vyomvmehta/RoboArm/README.md

# RoboArm

A 5-servo desktop robot arm, designed in SolidWorks and 3D printed. Web-controlled in V1, gesture-controlled in V2.

- **V1 (in progress):** controlled from a web page on a laptop or phone. Drag a slider per joint, or type a point and the arm's inverse kinematics moves the gripper there.
- **V2 (next):** controlled by hand gestures. A webcam tracks your hand with MediaPipe; move your hand and the arm follows, pinch to close the gripper.

**Status (Nov 2026):** in progress. The plan, the laptop↔Arduino protocol and the arm's kinematics (with tests) are done. CAD, printing and electronics are next. Target: V1 controlled live from the web page in December 2026, then a pick-and-place demo and write-up in January 2027. V2 (gestures) follows.

**Team:** Vyom Mehta, Ishaan, Siddharth (University of Waterloo).

## How it works

```
V1: web page (laptop/phone) ─┐
                             ├→ Laptop (Python): target point → IK → Arduino Nano → PCA9685 → 5 servos
V2: webcam + hand tracking ──┘                                     (USB serial)    (I²C)
```

| Joint | Servo | Job |
| --- | --- | --- |
| J0 base | MG996R | Turns the arm left/right |
| J1 shoulder | MG996R | Raises/lowers the upper arm |
| J2 elbow | MG996R | Bends the forearm |
| J3 wrist | MG90S | Sets the gripper's angle |
| J4 gripper | MG90S | Opens/closes the two-jaw gripper |

## Repository

```
arm/kinematics/   forward + inverse kinematics
tests/            unit tests (run: python -m pytest)
docs/             PROTOCOL (laptop↔Arduino messages), TORQUE (arm-size strength check),
                  TIMELINE, DECISIONS, CHECKLIST
```

More folders (CAD, firmware, vision, config) arrive as each part is built.

## Run the tests

```
pip install pytest
python -m pytest -q
```

## How we built this

We use Claude Code (an AI assistant) as a tutor and pair programmer. It explains concepts before we build them and writes some of the code and docs. For example, the inverse kinematics was derived by hand first, then coded with Claude's help. A full account of who did what will be here with the final write-up.
