vyomvmehta/RoboArm/docs/img/base_rotation.gif

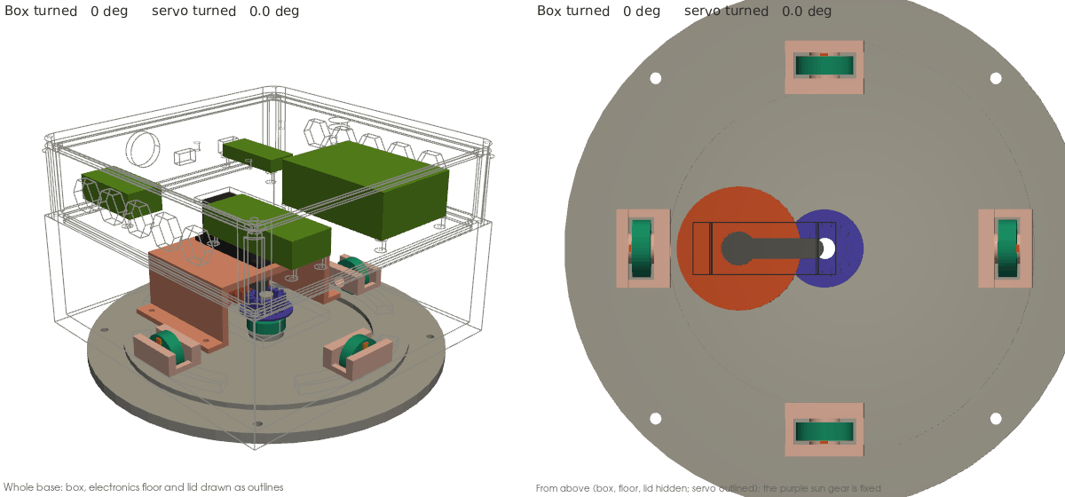
docs/img/base_rotation.gif
