vyomvmehta/RoboArm/SolidWorks Parts/README.md

# SolidWorks Parts

All CAD for the arm lives here and is shared through GitHub, like the code.

```
SolidWorks Parts/
  Test Prints/   test pieces for print clearances (batch A); throwaway, not part of the arm
  *.SLDPRT       arm parts: base, turntable, shoulder bracket, links, wrist, gripper
  *.SLDASM       the full arm assembly
  STL/           print files exported from the parts above (batch B and reprints)
```

## Rules

- **Keep the arm's parts and its assembly in this one folder.** A SolidWorks assembly finds its parts by file name, and looks in its own folder first. That way it opens on every laptop, wherever the repo is cloned.
- **Never rename a part to make a new version** (no `_v2`). Renaming breaks the assembly's links to it. Git already keeps every version: change the file, commit it, and say what changed in the commit message.
- **One person edits a file at a time.** SolidWorks files are binary, so git can't merge two people's changes; one person's work would be lost. Say in the group chat before editing a part someone else owns, and pull first.
- **Pull before you open, push when you're done:** `git pull` → edit → save → commit → push (through a pull request, like code).
- **Export STLs in millimetres, resolution Fine,** into `STL/`. Re-export after every change, so the STL never lags behind the part.
- Lock files (`~$*.SLDPRT`) and backups (`*.SLDBAK`) are ignored by git; don't force-add them.

## Test Prints

| File | What it tests |
| --- | --- |
| `Screw_Strip.SLDPRT` / `.STL` / `.3MF` | M3 screw holes 3.0 / 3.2 / 3.4 mm, M3 nut pockets 5.6 / 5.8 / 6.0 mm across the flats |
| `bearing_block.py` → `bearing_block.stl` | 608 bearing seats 22.0 / 22.2 / 22.4 mm. Generated by the script (`py "SolidWorks Parts/Test Prints/bearing_block.py"`, needs `pip install manifold3d`) |
| `motor_frames.py` → `mg996r_frames.stl`, `mg90s_frames.stl` | MG996R (19.8 × 40.5) and MG90S (11.9 × 22.8) body pockets at +0.10 / +0.25 / +0.40 mm (labels 10 / 25 / 40) |

The fits that work are recorded in `docs/DECISIONS.md` (D15).
