vyomvmehta/RoboArm/SolidWorks Parts/grap_base_assembly.step

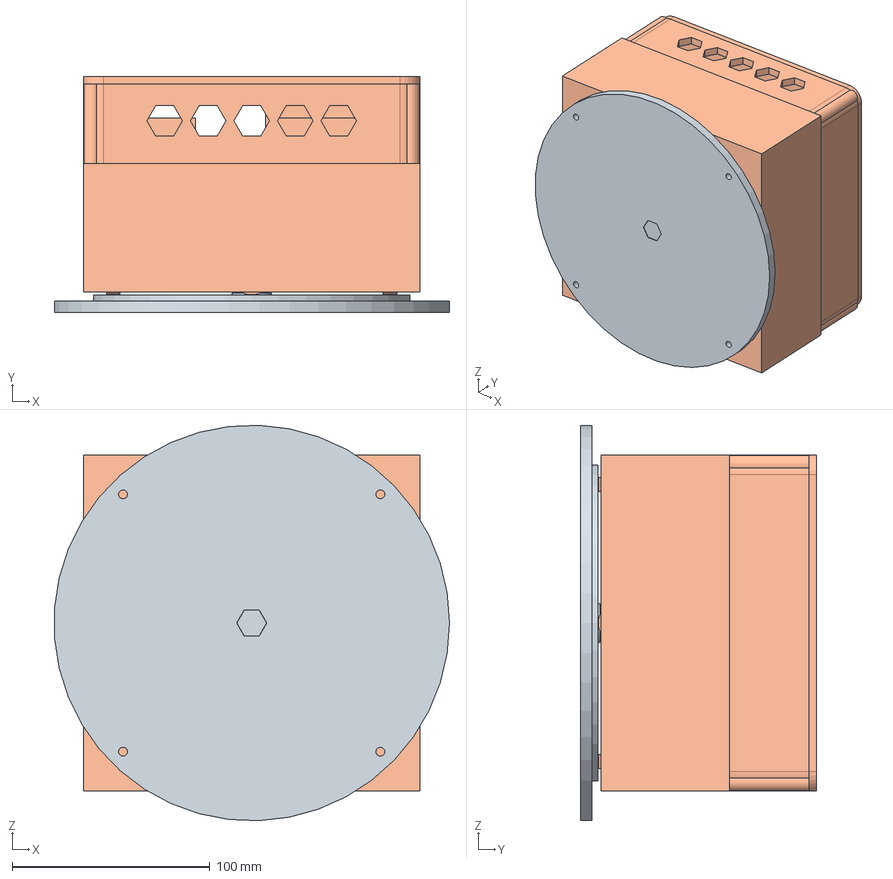
[picture p2: CAD file, 2026-11-14]
SolidWorks Parts/grap_base_assembly.step
199.7 x 119.5 x 199.9 mm
base
pivot_bolt
sun_gear
planet_gear
horn
servo
servo_bridge
pivot_bearing
fork0
wheel0
fork1
wheel1
fork2
wheel2
fork3
wheel3
tier
board_pca9685
board_perfboard
board_lm2596
board_nano
lid
