vyomvmehta/RoboArm/SolidWorks Parts/grap_planet_gear.step

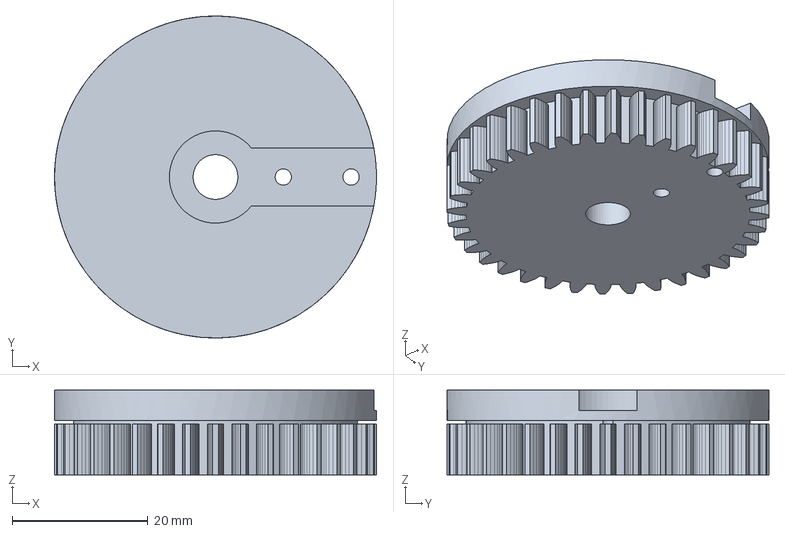
[picture p3: CAD file, 2026-11-14]
SolidWorks Parts/grap_planet_gear.step
47.5 x 47.5 x 12.5 mm
