vyomvmehta/RoboArm/SolidWorks Parts/Test Prints/mg996r_frames.stl

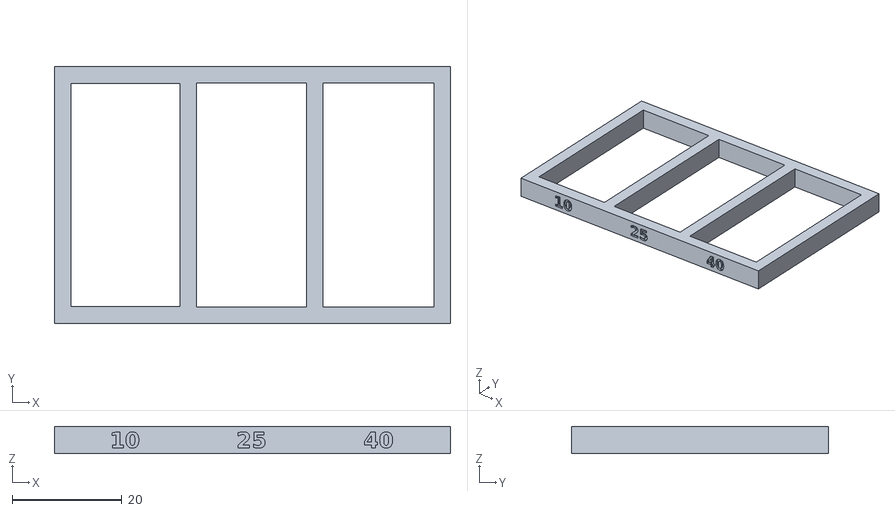
[picture p4: CAD file, 2026-11-04]
SolidWorks Parts/Test Prints/mg996r_frames.stl
72.2 x 46.9 x 5.00
