vyomvmehta/RoboArm/SolidWorks Parts/grap_lid.step

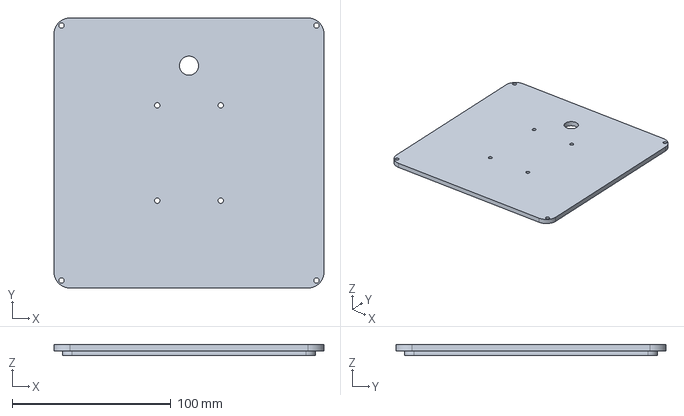
[picture p5: CAD file, 2026-11-14]
SolidWorks Parts/grap_lid.step
170.0 x 170.0 x 7.00 mm
