vyomvmehta/RoboArm/SolidWorks Parts/Test Prints/mg90s_frames.stl

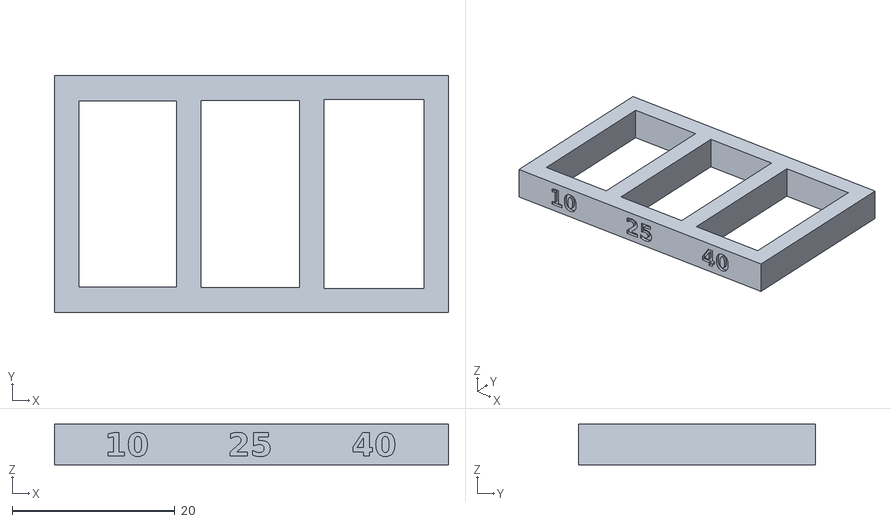
[picture p6: CAD file, 2026-11-04]
SolidWorks Parts/Test Prints/mg90s_frames.stl
48.5 x 29.2 x 5.00
