vyomvmehta/RoboArm/SolidWorks Parts/grap_wheel_fork.step

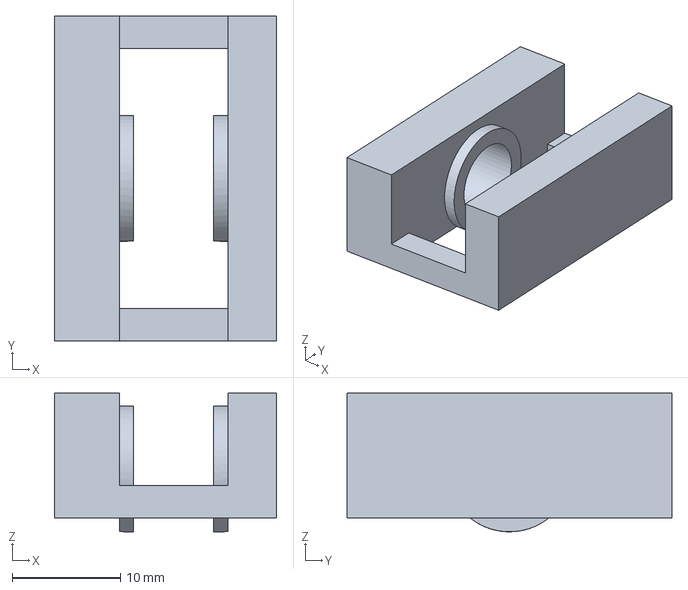
[picture p7: CAD file, 2026-11-14]
SolidWorks Parts/grap_wheel_fork.step
20.5 x 30.0 x 12.8 mm
