vyomvmehta/RoboArm/SolidWorks Parts/Test Prints/bearing_block.stl

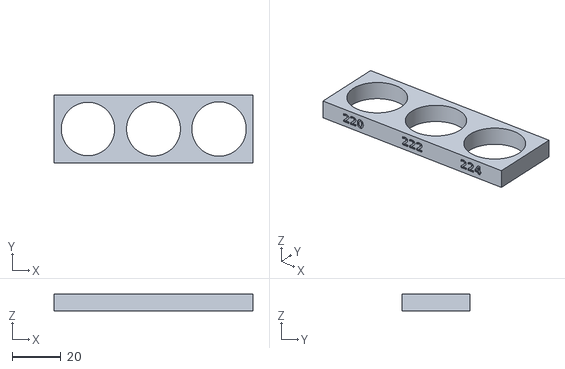
[picture p8: CAD file, 2026-11-04]
SolidWorks Parts/Test Prints/bearing_block.stl
82.0 x 28.0 x 7.00
