vyomvmehta/RoboArm/SolidWorks Parts/grap_servo_bridge.step

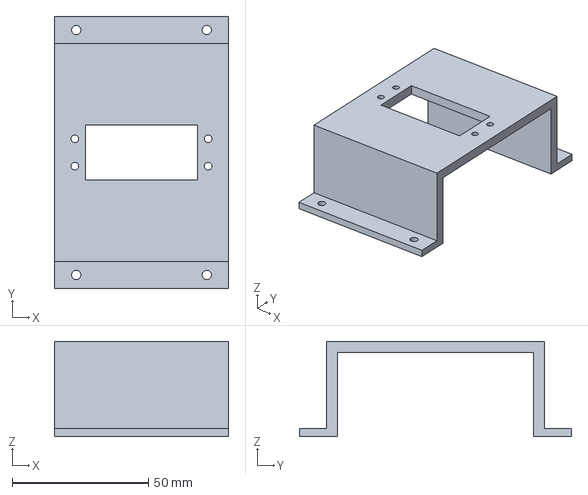
[picture p9: CAD file, 2026-11-14]
SolidWorks Parts/grap_servo_bridge.step
64.0 x 100.0 x 35.0 mm
