vyomvmehta/RoboArm/SolidWorks Parts/grap_sun_gear.step

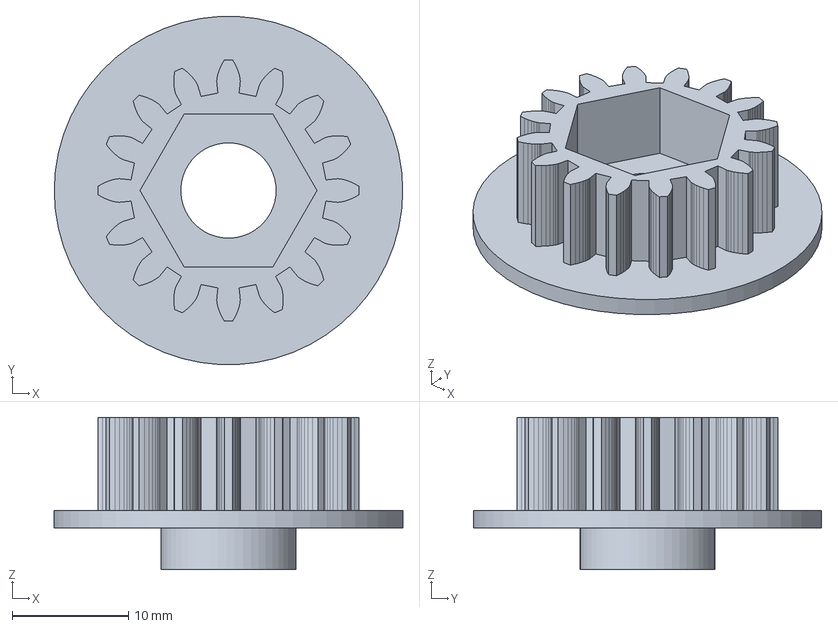
[picture p10: CAD file, 2026-11-14]
SolidWorks Parts/grap_sun_gear.step
30.0 x 30.0 x 13.1 mm
