vyomvmehta/RoboArm/SolidWorks Parts/grap_electronics_tier.step

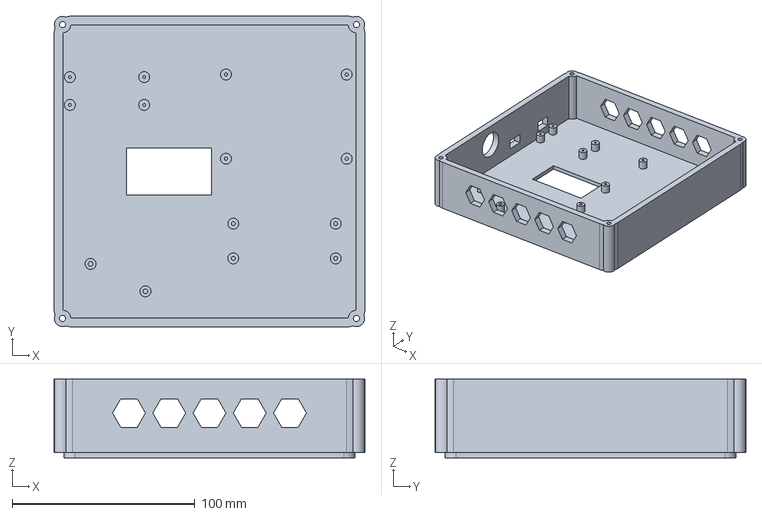
[picture p11: CAD file, 2026-11-14]
SolidWorks Parts/grap_electronics_tier.step
170.0 x 170.0 x 43.0 mm
