vyomvmehta/RoboArm/SolidWorks Parts/grap_base.step

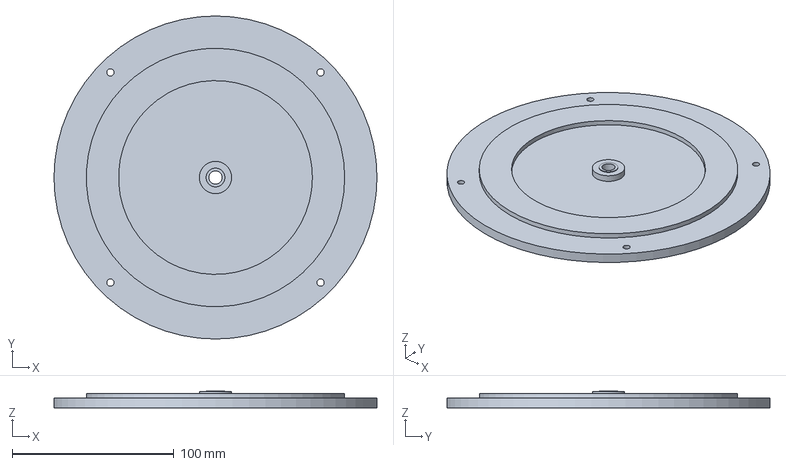
[picture p12: CAD file, 2026-11-14]
SolidWorks Parts/grap_base.step
200.0 x 200.0 x 10.4 mm
