vyomvmehta/RoboArm/SolidWorks Parts/Enclosure.SLDPRT

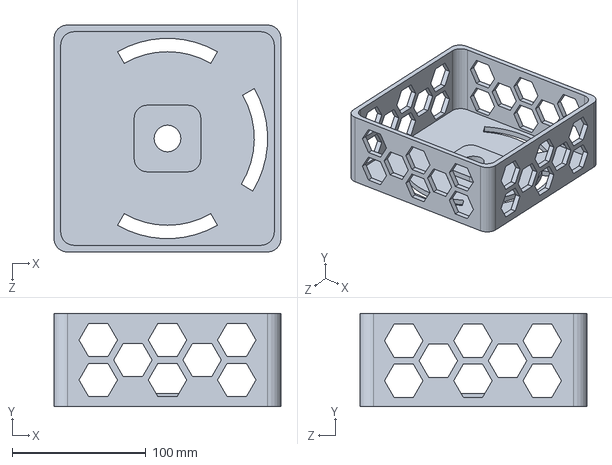
[picture p13: CAD file, 2026-11-14]
SolidWorks Parts/Enclosure.SLDPRT
170.0 x 70.0 x 170.0 mm
