vyomvmehta/RoboArm/SolidWorks Parts/Test Prints/Screw_Strip.SLDPRT

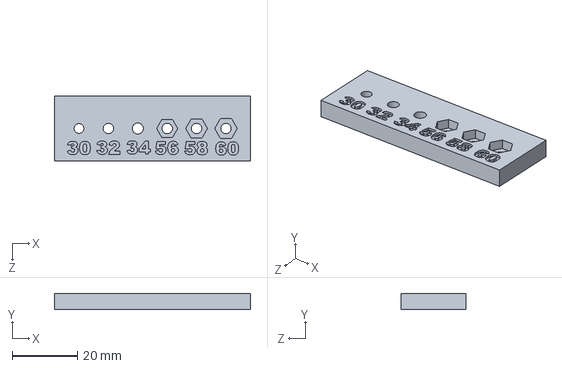
[picture p14: CAD file, 2026-11-04]
SolidWorks Parts/Test Prints/Screw_Strip.SLDPRT
60.0 x 5.00 x 20.0 mm
