vyomvmehta/RoboArm/(list of files, cad)

Other CAD files:
SolidWorks Parts/STL/grap_base.stl
SolidWorks Parts/STL/grap_electronics_tier.stl
SolidWorks Parts/STL/grap_lid.stl
SolidWorks Parts/STL/grap_planet_gear.stl
SolidWorks Parts/STL/grap_servo_bridge.stl
SolidWorks Parts/STL/grap_sun_gear.stl
SolidWorks Parts/STL/grap_wheel_fork.stl
SolidWorks Parts/Test Prints/Screw_Strip.STL
