vyomvmehta/RoboArm/(commit log)

2026-11-01 Add forward/inverse kinematics with unit tests
2026-11-01 Add shoulder torque check; record D11-D12 and parts arrival date
2026-11-01 Address review: align torque (D12) and motion-limiter ownership (D8), restore print caps, retitle README, extend torque check
2026-11-04 Add test print parts; record D13 (electronics in base) and D15 (print clearances)
    [Screw_Strip.SLDPRT, Screw_Strip.STL, bearing_block.stl]
2026-11-04 Add motor frame test pieces; record D16 (15 V trigger + XL4015) and printer settings
    [mg90s_frames.stl, mg996r_frames.stl]
2026-11-09 Add arm.yaml + loader, servo bench-test sketches; update D11/D14-D16, torque and timeline
    - config/arm.yaml: link lengths (11/10/7, D14 on hold), joint windows/limits, poses, workspace
    - arm/config.py loader with checks; tests/test_config.py
    - firmware/bench_test (Servo lib) and bench_test_pca (PCA9685: I2C scan, registers, channel walk)
    - DECISIONS: D11 demo to January, D14 on hold, D15 pocket/cable-slot/mounting sizes, D16 power updates + stall test
    - TORQUE: wrist, clone margin, current estimate; TIMELINE: Nov 8 re-plan
    [arm.yaml, bench_test.ino, bench_test_pca.ino]
2026-11-09 V1 web control steps 1-4: server, sliders, calibration, protocol frames
    - arm/web: FastAPI + WebSocket server, slider page built from arm.yaml, 30 Hz latest-wins throttle
    - arm/calibration.py: joint_to_pulse (Vyom), gripper mm -> pulse, loader for config/calibration.yaml
    - config/calibration.yaml: placeholder values, owned by Ishaan
    - arm/comms: protocol encode/decode (XOR checksum) matching PROTOCOL.md test vectors; FakeLink
    - Out-of-range targets are rejected and reported to the page, never clamped
    - D8: base/gripper swap (Siddharth base, Vyom gripper)
    [calibration.yaml]
2026-11-10 Step 5: real serial link, safe arming, 30 Hz heartbeat, dead-man disarm
    - arm/comms/link.py: SerialLink (pyserial + reader thread), FakeNano (firmware v0 rules), banner wait
    - arm/control.py: arm -> first C = park pose -> sliders; fixed-rate heartbeat; reject bad targets
    - server: Arm/Disarm, live Nano state + round-trip time on the page, one controlling browser,
    disarm on browser disconnect and on server exit; --fake and --port options
    - config/comms.yaml: port, baud, banner timeout, heartbeat rate
    - 11 new tests (49 total)
    [link.py]
2026-11-10 Read serial replies as they arrive; fixes inflated round-trip time (40 -> 12 ms on the bench)
    read(64) on Windows waited for 64 bytes (several K replies) or the 0.1 s timeout, delaying
    each reply. Reading in_waiting (at least 1 byte) handles each reply as soon as it lands.
    [link.py]
2026-11-10 Bench findings: MG90S ~12 us/deg (not 5.6); HOLD-forever question added to PROTOCOL
    [calibration.yaml]
2026-11-10 MG90S: 180 deg = 650-2600 us (~11 us/deg); usable ~500 to >2600
    [calibration.yaml]
2026-11-10 Bench sketch: allow 400-2600 us to find the real servo end stops
2026-11-11 Add docs/PINS.md: signal pin map, servo channels, power path
2026-11-11 Address PR #6 review: FakeNano mirrors the firmware's handlers; limits read from the .ino
    - H while armed -> K (was E5); wrong C field count -> E2 (was accepted); A/D/H/P with
    fields -> E2; checks in the same order as handle_c/a/d/h/p
    - FakeNano reads PULSE_MIN/PULSE_MAX from firmware/arm_controller.ino (no third copy)
    - park_values uses named JointAngles fields instead of vars() order
    - 13 tests: a firmware reply table + limits parsed from the source
    [link.py]
2026-11-12 Address PR #7 review: 9 V trigger, PLANNED tags, 360-degree servo note, add bench tools
2026-11-13 Per-joint firmware limits from measured servo travel; add five_servo_test
2026-11-14 Uniform hard limits 450-2450 (agreed with Vyom); fix five_servo_test abort and sweep
    [arm_controller.ino, five_servo_test.ino]
2026-11-14 Uniform hard limits 450-2500 (agreed with Vyom); fix five_servo_test abort and sweep
    [arm_controller.ino]
2026-11-14 Match revised measurement: centre 1475, bench limits 500-2450, correct the limits comment
    [arm_controller.ino, five_servo_test.ino]
